Davibeh/Switch_De_Distorcion_Ergonomico/02_ Materiales_y_Compras/Tickets_Recibos/20180318_181217.jpg

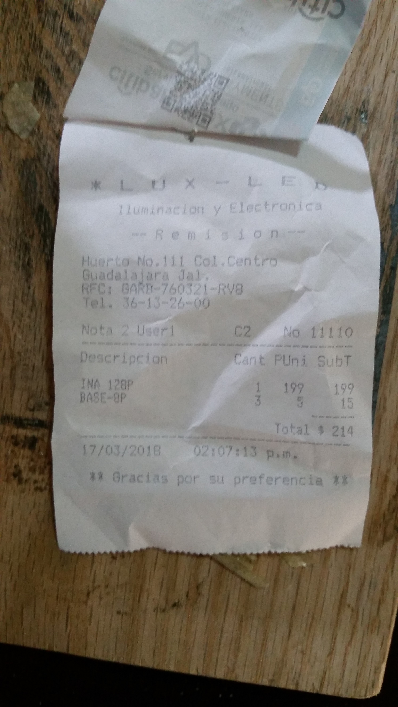
02_ Materiales_y_Compras/Tickets_Recibos/20180318_181217.jpg
