Davibeh/Switch_De_Distorcion_Ergonomico/01_PM/WBS_Plan_ALFA_Switch_de_distorción_ergonómico.pptx

Switch de distorsión ergonómico
(Variante ALFA)
Desarrollo de 2 circuitos de offset y ganancia
Diseñar circuito con amplificadores operacionales para amplificar y agregar un offset a una señal
Electro-miógrafo
Armar el circuito diseñado en protoboard
Diseñar el layout del circuito funcional
Desarrollar tarjeta de desarrollo
Diseñar un circuito capaz de leer biopotenciales musculares y amplificarlos
Armar el circuito en protoboard
Probar el circuito armado
Diseñar layout
Desarrollar tarjeta de desarrollo
Probar circuito armado
Firmware
Hardware
Probar tarjeta de desarrollo
Probar tarjeta de desarrollo
Driver para convertidor analógico a digital(ADC)
Desarrollo de drivers
Efectos de sonido
Electro-miógrafo
Driver para Digital to Analog Converter (DAC)
Driver para General Purpose input/output (GPIO)
Driver para Periodic interrupt timer (PIT)
Desarrollar algoritmo para obtención de datos
Desarrollar algoritmo para procesamiento de datos
Encapsular ambos algoritmos en una función
Desarrollar algoritmo de obtención de datos
Desarrollar algoritmo para generar efecto de sonido: echo
Desarrollar algoritmo para generar efecto de sonido: distorsión
Desarrollar algoritmo para generar efecto de sonido: vibrato
Encapsular una función por efecto que contenga el algoritmo de obtención de datos y el algoritmo para generar el efecto respectivo
Análisis previo y compras
Realizar BOM para dos circuitos de offset y ganancia
Realizar BOM para electro-miógrafo
Ir comprar los objetos listados en las BOM realizadas
Administración de juntas para el proyecto juntas
Administración de tares para el proyecto
Creación de matriz raci
Documentación
Creación del proyecto charter
Ejecución de pruebas de variante alfa
Revisión del documento de diseño
