Davibeh/Switch_De_Distorcion_Ergonomico/01_PM/WBS_Plan_BETA_Switch_de_distorción_ergonómico.pptx

Switch de distorsión ergonómico
(Variante BETA)
HW de Audio
HW de suma y resta analógica para el audio.
Electro-miógrafo
Entendimiento del HW del electro miógrafo
Puntos de medición identificados.
Preparación de plan BETA
Hardware
Rediseño
Plan definido de variante BETA
Material comprado para variante BETA
Arquitectura de HW modificada
Arquitectura de SW modificada
Miógrafo de un proveedor externo
Materiales varios como JACKs de audio
Software
Software de detección de movimiento del miógrafo
Software de generación de señal de distorsión
Software de sistema mínimo par el control del procesador.
HW de instrumentación señal salida de miógrafo
HW y SW integrado
Integración
Pruebas del sistema
