Davibeh/Switch_De_Distorcion_Ergonomico/01_PM/Minutas de Juntas/G Proyectos de Sw.pdf

- Definir alcance del proyecto, enuncia enlistando el objetivo.
- Generar Project Charter.
- Definir personas involucradas y competencias de cada una.
- Matriz RACI.
- Definir WBS.
- Actividades de desarrollo, metodología de desarrollo de SW.
- Presupuesto
- Tiempo estimado de las actividades.
- Personas asignadas.
- Definir juntas de estado (Semanales)
- Planeación:

Agenda:

# Fechas importantes

Fecha de entrega 14 de Abril
Dias semana natural:

### 35 dias

_______________________________________ Disponibilidad
Chung: Jueves 29 Marzo al domingo 1 de Marzo

Gerardo Vacaciones:
Lunes a viernes : Apartir de las 5pm
Sabado 24 de Marzo - 25 de Marzo Jueves 29 de Marzo 1 de Abril

Obejtivo del proyecto:

Gerardo enunciado: Prototipado de un pedal activado por biopotenciales. Que incluye el prototipado:
Demostración de un protopido de pedal activado por biotenciales.

Background:
El humano ha dependido de la utilización de elementos externos que cumplen el rol de interfaz para traducir el objetivo de control del humano a las maquinas que servirán de actuadores. Estos elementos externos plantean un problema por la baja integración que tienen con el controlador humano.
La importancia de crear elementos interface que se acoplen de manera ergonómica al controlador humano es la tendencia moderna para crear nuevos dispositivos electrónicos en diferentes áreas, como el caso de la electrónica de consumo tales como teclados, pizarrones virtuales, etc.

Objetivo:
Para la industria de la música la adquisición de equipo es un tema primordial, buscando tener equipo que provea la mejor calidad de audio. la instalación de estos equipos en las presentaciones en vivo resultan un contratiempo, un caso muy particular para los guitarristas los pedales de distorcion cumplen una funcion primordial, pero mantienen a los muscios en un area para poder indicar los cambios de distorcion a lso sonidos de la guitarra.
El proyecto tienen como objetivo el crear un prototipo de pedal que se integre ergonomiament al musico donde los cambios de distoricion estaran cotnrolador por el movimiento de las piernas del musico, dandole la liberdad de movimiento en el escenario.
- Chung: Programan, HW
- Gerardo Programa, HW
- Eduardo Gamboa Pro, Hw , Git
- David Pro, HW
- Tooling: Git

CMP:

TODO: Entrenamiento o manual.

SW Driver pre existentes:

- Driver de ADC.
- Driver de de timer PIT
- Driver de DAC 12 bits
- GPIOS drivers
- Efectos de sonido
- Evaluador miagrafo (modificacion par aun canal extra)
- Pedal applicacion

Capa de apliacion:

Proceso de Activación:

Sera de dos fases, una fase sera la permisiva y la segunda fase sera la de actiación:

•

LA primera fase se locarizaro en los cuadricepts de la peirna derecha.

LA segunda sera en los gemelos.

Experiencia de usuario:
Es la de estirar la pierna e inclinar el pie hacia abajo para activar o desactivar el efecto.

El usuario seleccionara manualmente el efecto con un boton.

La intesidad de los efectos de sonido sera controlada por un unico ptenciametro.

La cantidad de efectos disponibles era de 3:

1- Vibrato
Eco2-
3- Distorcion

Horas de trabajo al dia son 4 horas

WBS:

- Project Charter(Documentacion inicial)
- Escritura de requeremientos de sistema.

Requirement enginieering:

- HW/SW architecture creation.

HW/SW Architecutre:

- Construir proto con hw de miografo
- Validar contruccion del proto
- Design Migrafro HW.
- Contrurir proto
- Validar proto
- Deseing migrafo intrumentation hw (no negative)
- HW integration test. (SW integration test)
- PCB deseing
- PCB construction
- PCB validation

HW disipline:

HSI

- Adaptacion de Codewarrior a Mcu expresso 1 de trabajo
- Validation of the sw 1 dia de trabajo lunes pruebas
- BSW preparación:
- Aplication coding 16 dias.
- Escribir pruebas de SW
- Ejecutar pruebas de SW

SW discipline:

Calibration of the SW

- MCU expresso.
- Doxygen--> instalation for Chung

SW Tooling:

- Platform listo

Para miecoloes:

- No tener ningun HW preehecho.
Caso de etner HW prehecho la adaptacipn y entendiento del HW puede consumir tiempo.

•

Riesgos:

# 10/03/18: Junta de equipo definición del proyecto

viernes, 09 de marzo de 2018 06:53 p.m.

G Proyectos de Sw Page 1

Materiales:

- Electrodos -> 50 ~ $400 tiempo de adiquision 1dia.
Cables electrodos 1 por fase ---$300 1 semana en llegar desde que se pide --> al momento de prueas de integración. --> Miercoles. Ya habra estatus.

•

- Jueves compra de materiales.
- HW del miografo (dieño de la terjeta y contruccion de la misma) 4 dias
- Compra 741 no. Otro si.
- INA ( Instrumentation Ampliafiar)
- Guitarra
- Amplificador
- Cable de guitarra
- Adapador de jacks.
- Op amp de salida.
- Validation of the sw 1 dia de trabajo lunes pruebas
- Aplication coding 16 dias.
- Escribir pruebas de SW
- Ejecutar pruebas de SW
- Pruebas de integracón

Pruebas systemas

- No tener ningun HW preehecho.
Caso de etner HW prehecho la adaptacipn y entendiento del HW puede consumir tiempo.

•

- Quemado del HW prehecho. Del miografo.
- Queado del HW ya hecho
- Tarjeta de desarrollo quemada.
- Impedancia de la piel que no permita leer la informacion (muy bajo riegos)
- Que se desponga el disco duro.

Riesgos:

Riesgo:

- Osciloscopio
- Fuente

Equipo durante la parte de vacaciones

Pedir oscilosopio
A concoidos

G Proyectos de Sw Page 2
