Davibeh/Switch_De_Distorcion_Ergonomico/01_PM/WBS_Plan_ALFA_BETA_INTEGRATION_Switch_de_distorción_ergonómico.pptx

Switch de distorsión ergonómico
Integración ALFA BETA
Integración
Integración del HW de la variante ALFA y BETA
Pruebas de integración
Preparación de plan ALFA BETA
Hardware
Proyecto en un servicio de almacenamiento en la nube.
Software
Pruebas de integración del software
Software de muestreo de Audio
Integración del software de control de Electro miógrafo y muestreo de audio
Pruebas de integración del sistema con guitarra eléctrica.
Integración
Tickes de actividades pedientes
