Davibeh/Switch_De_Distorcion_Ergonomico/03_Investigacion_y_Desarrollo/02_Arquitectura/Arquitectura software_Imagen_Gerardo.jpg

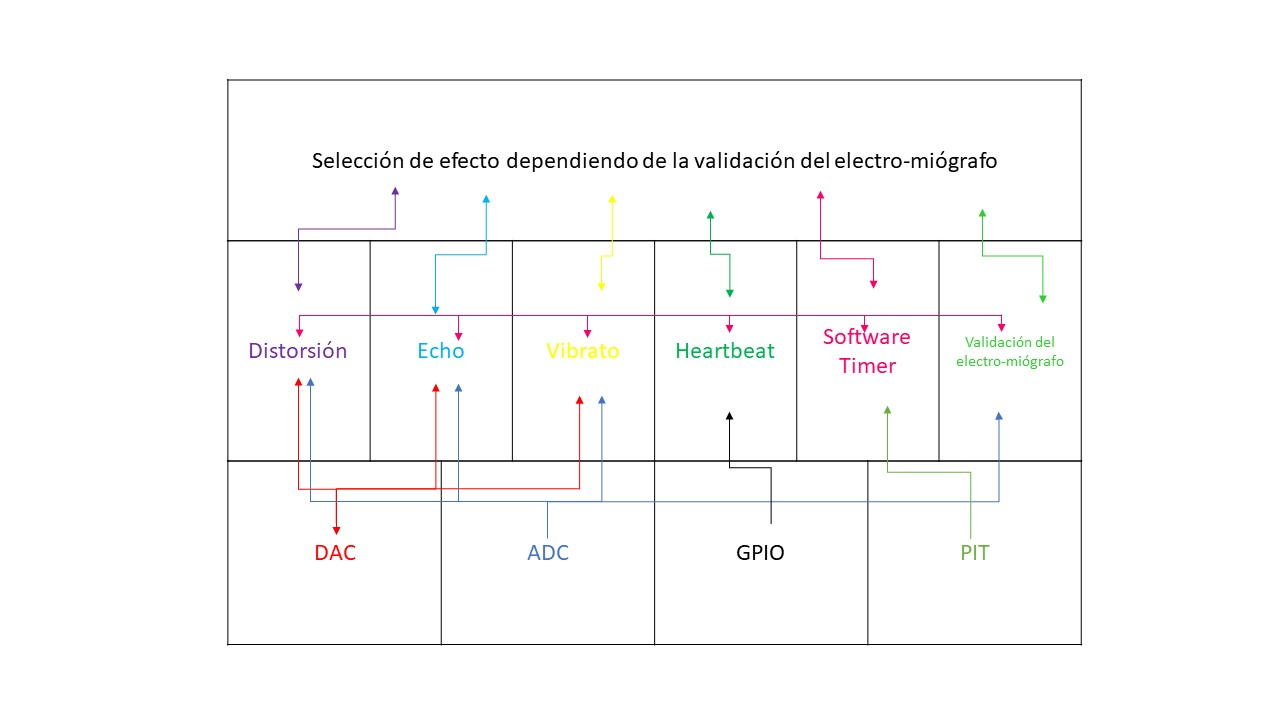
03_Investigacion_y_Desarrollo/02_Arquitectura/Arquitectura software_Imagen_Gerardo.jpg
