Davibeh/Switch_De_Distorcion_Ergonomico/02_ Materiales_y_Compras/BOM para Proyecto.xlsx

Sheet: Sheet1
Refdes | Cantidad | Descricpion
Resistencia 10k ohm | 19
Resistencia 240 ohm | 1
Resisencia 1Kohm | 5
Resistencia 4.7Kohm | 5
Resistencia 150kohm | 5
Resistencia 15Kohm | 5
Resistencia 27Kohm | 5
Potenciometro ?? | 1 | En el esquematico del electromiografo hay un potenciometro llamado R13 pero este no especifica el rango de su resistencia.
Potenciometro-50k | 4 | 50 k
Potenciometro 100k | 4 | 10k
Conector de Audio analogico | 7 | jack hembra de 3.5mm para stereo
lm358 | 5 | Amplificadores operacionales duales 8 pins
capacitor 4uf | 6
Capacitor ,1uf | 3
Capacitor 220nf | 3
Capacitor 100nf | 3
OpAmp | 3 | TL082P
Diodo 1N4004 | 2
Diodo 1N4148DO35-10 | 2
Amplificador de instrumentacion | 1 | No se la matricula
Base para IC | 7 | Base dip para circuito integrado 8 pines

Sheet: Electro_Miografo
Part | Value | Device | Package
C1 | 220n | CPOL-USE2-5 | E2-5
C5 | .1u | CPOL-USE2-5 | E2-5
C6 | 100n | CPOL-USE2-5 | E2-5
C7 | 100n | CPOL-USE2-5 | E2-5
D1 | 1N4148DO35-10 | 1N4148DO35-10 | DO35-10
D2 | 1N4148DO35-10 | 1N4148DO35-10 | DO35-10
D3 | 1N4004 | 1N4004 | DO41-10
D4 | 1N4004 | 1N4004 | DO41-10
IC1 | INA128P | INA128P | DIL08
IC2 | TL082P | TL082P | DIL08
IC3 | TL082P | TL082P | DIL08
R1 | 240 | R-US_0207/12 | 0207/12
R2 | 150k | R-US_0207/12 | 0207/12
R3 | 10k | R-US_0207/12 | 0207/12
R4 | 10k | R-US_0207/12 | 0207/12
R5 | 4.7k | R-US_0207/12 | 0207/12
R6 | 1k | R-US_0207/12 | 0207/12
R7 | 1k | R-US_0207/12 | 0207/12
R8 | 27k | R-US_0207/12 | 0207/12
R9 | 27k | R-US_0207/12 | 0207/12
R10 | 15k | R-US_0207/12 | 0207/12
R11 | 15k | R-US_0207/12 | 0207/12
R12 | 15k | R-US_0207/12 | 0207/12
R13 |  | 3RP/1610N | 3RP/1610N
R14 | 1k | R-US_0207/12 | 0207/12
X1 | 22-23-2031 | 22-23-2031 | 22-23-2031 | Conectores
X2 | 22-23-2031 | 22-23-2031 | 22-23-2031
X3 | 22-23-2031 | 22-23-2031 | 22-23-2031
