Davibeh/Switch_De_Distorcion_Ergonomico/03_Investigacion_y_Desarrollo/01_Requerimientos/Req_Switch_Ergonomico.xls

Proyecto |  |  | Switch Ergonomico
Documentos de Referencia |  |  | Reference documents
Revisado por |  |  | Nombre del Revisor |  |  |  |  |  | Extra requirement traceability information Comments and deviations |  | Design Traceability |  | Code Traceability |  |  | Testing Traceability Matrix
 |  |  |  | Estado | Implementación | Completo | Trazable a | Verificable
Id | Tipo | Sección | Requerimientos |  |  |  |  |  | Comentarios 1 | Comentarios 2 | Documento/Sección | Comentarios | Module/Files | Functions | Comments | Document/Test ID | Comments
RQ001 | No Funcional | Cabezera | Detección del Movimiento | Propuesto
RQ002 | Funcional | Requerimiento | El sistema debe de detectar el movimiento del musculo gastrocnemio | Propuesto
RQ003 | Funcional | Requerimiento | El movimiento del músculo debe ser medido usando electrodos siguiendo el principio de la electromiografia. | Propuesto
RQ004 | Funcional | Requerimiento | Se deberá utilizar 3 electrodos siguiendo el principio de voltage diferencial y voltaje de referencia. | ASD
RQ005 | Funcional | Requerimiento | La señal de voltaje extraida de los electródos deberá ser instrumentada para el posterior procesamiendo de un microprocesador. | Propuesto
RQ006 | Funcional | Requerimiento | La fase de instrumentación de la señal de voltaje debera constar de tres fases: 1- Diferenciación de voltaje y amplificación de la diferencia (por ejemplo usando un amplificador de instrumentación). 2- Fase de rectificación de señal. 3- Fase de desacoplamiento. 4- Fase de atenuación de picos de voltage. | Propuesto
RQ007 | Funcional | Requerimiento | La señal de voltaje de salida del proceso de intrumentación deberá ser de naturaleza de corriente directa. | Propuesto
RQ008 |  |  | El valor de voltaje de corriente directa de salida del proceso de intrumentación será directamente proporcional al movimiento del músculo. | Propuesto
RQ009 | No Funcional | Requerimiento | El implementador deberá tipificar la relación entre los niveles de voltage obtenidos de la fase de intrumentación y el movimiento del musculo gastrocnemio. | Propuesto
RQ010 | Funcional | Requerimiento | El procesador deberá de muestrear la señal de voltaje para detectar cualquier variacion de la amplidud de la misma con un periodo máximo de 100ms. | Propuesto
RQ011 | Funcional | Requerimiento | El procesador deberá de detectar la existencia de movimiento en el músculo y notificar de este evento al SW de control. | Propuesto
RQ012 | No Funcional | Requerimiento | La señal de voltaje obtenida de la fase de instrumentación deberá de lograr un rechazo de modo común a las señales de ruido, logrando asi un valor maximo de la relación Señal/Ruido y una distroción minima. | Propuesto
RQ013 | No Funcional | Cabezera | INTERFAZ DE USUARIO
RQ014 | No Funcional | Requerimiento | El usuario deberá de ser capaz de activar o desactivar el efecto de sonido aplicado al audio mediante un movimiendo sencillo del pie | Propuesto
RQ015 | Funcional | Requerimiento | El movimiento de desactivacion cosnistirá en el mostrado en la figura mientras el usuario se encuentra en posicion de sentado y el efecto de audio esta desactivado. | Propuesto
RQ016 | Funcional | Requerimiento | El movimiento de desactivacion cosnistirá en el mostrado en la figura mientras el usuario se encuentra en posicion de sentado y el efecto de audio esta activado. | Propuesto
RQ017 | No Funcional | Cabezera | MUESTREO DE AUDIO
RQ018 | Funcional | Requerimiento | El muestreo de Audio por parte del procesador deberá tener un periodo maximo de 84us | Propuesto
RQ020 | NoFuncional | Cabezera | SALIDA DE AUDIO | Propuesto
RQ021 | Funcional | Requerimiento | La frecuencia de muestreo de la señal de audio debera ser de 20khz | Propuesto
RQ022 | Funcional | Requerimiento | La frecuencia de muestreo de la señal del miografo debera ser de 20khz | Propuesto
RQ023 | Funcional | Requerimiento | El sistema debeera de contar con la capacidad de aplicar 3 efectos de sonido de audio | Propuesto
RQ024 | Funcional | Requerimiento | El efecto de echo es la suma de la entrada de audio mas la misma entrada desfasada atrás en el tiempo | Propuesto
RQ025 | Funcional | Requerimiento | El efecto de vibrato se monta la entrada de audio a una onda de dientes de sierra | Propuesto
RQ026 | Funcional | Requerimiento | El sistsistema debera teber la capacidad de muestrear y validar la señal de voltage y validar ka selak de voltage provista por el usuario | Propuesto
RQ027 | Funcional | Requerimiento | El sistema debera de ser capas de contar con periferico de salida de voltage alaolgico | Propuesto
RQ028 | Funcional | Requerimiento | El sistema debera ser capas de contar con un periferico de entrada de voltage abnalogico | Propuesto
RQ029 | Funcional | Requerimiento | El sistema debera ser capas de contar con un periferico de GPIOS | Propuesto
RQ030 | Funcional | Requerimiento | El sistema debera ser capas de contar con un periferico de timer | Propuesto
RQ031 | Funcional | Requerimiento | El procesador deberea dar la salida de audio por el modulo DAC0 | Propuesto
RQ032 | Funcional | Requerimiento | La app total debera seleccionar el efecto dependiendo de la validacion del electro-miografo | Propuesto
RQ033 | Funcional | Requerimiento | La sallida debera presentar los efectos de distorsion ,echo y vibrato dependeiendo de la selección del usuario | Propuesto
RQ034 | Funcional | Requerimiento | El sistema contara con un selector de modos de distorcion | Propuesto
RQ035 | Funcional | Requerimiento | El pit sera encargado de de administrar los tiempos | Propuesto
