Davibeh/Switch_De_Distorcion_Ergonomico/03_Investigacion_y_Desarrollo/04_Implementacion_SW/SDDE/doc/SW Embedded Tutorials.docx

[SW Embedded Tutorials] Digital To Analog Converter

Descripcion:

En este tutorial describiremos de manera breve el convertidor Digital a Analogico. Ademas se mostrara un caso de uso para la plataforma KL25Z.

Links:

Informacion en Wikipedia sobre DAC:

https://es.wikipedia.org/wiki/Conversi%C3%B3n_digital-anal%C3%B3gica

Pagina NXP KL25Z:

https://www.nxp.com/products/processors-and-microcontrollers/arm-based-processors-and-mcus/kinetis-cortex-m-mcus/l-seriesultra-low-powerm0-plus/freedom-development-p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

Pagina SDK KL25Z:

https://www.nxp.com/support/developer-resources/reference-designs/software-development-kit-for-kinetis-mcus:KINETIS-SDK
