Davibeh/Switch_De_Distorcion_Ergonomico/03_Investigacion_y_Desarrollo/02_Arquitectura/Manual para abrir el archivo de arquitectura.docx

Manual para abrir el archivo de arquitectura

Autor: David Bellomo

Fecha: 29/03/18

Paso 1:

Ir a https://www.draw.io/

Paso 2:

Seleccionar la opción de Device

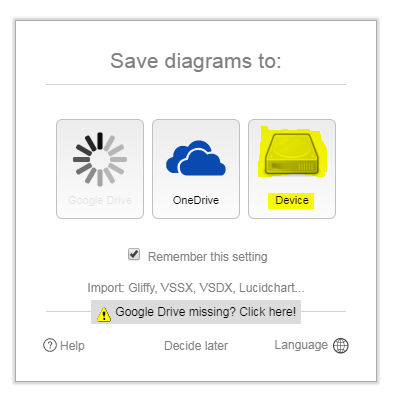
[picture p13: figure]

Paso 3:

Seleccionar la opción “Open Existing Diagram”

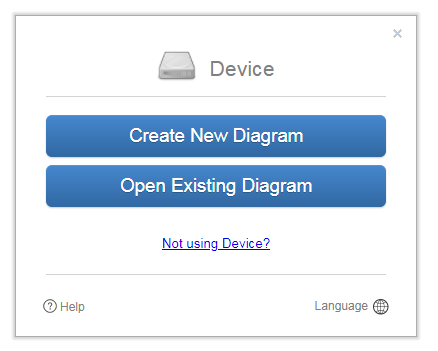
[picture p14: figure]

Paso 4:

Ubicar el archivo llamado “SW_HW_Architecture_Switch_Ergonomico.xml” y abrirlo.

Paso 5:

Empezar con la navegación/modificación de los diagramas

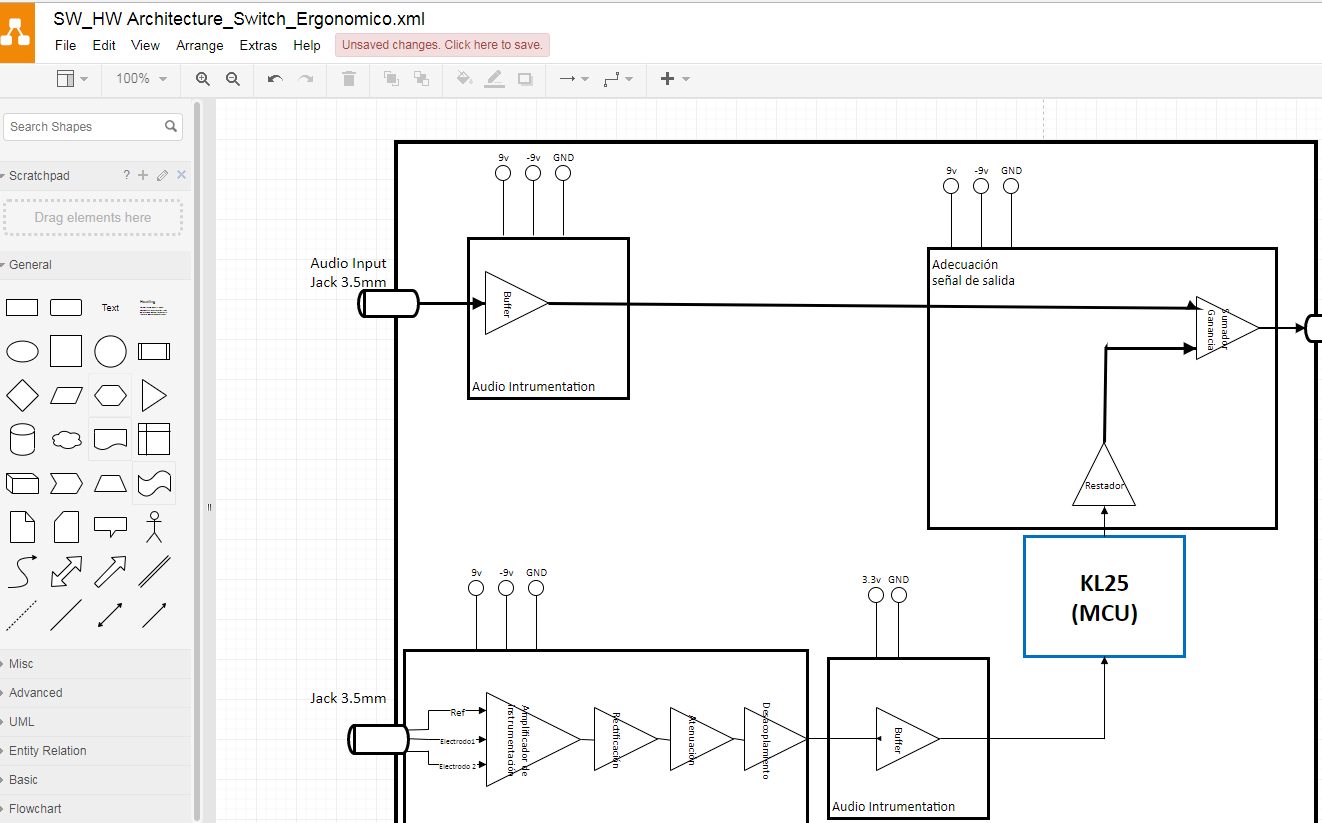
[picture p15: figure]
