Davibeh/Switch_De_Distorcion_Ergonomico/(threads)

Thread 1 (2018-03-30):

Crear Matriz RACI

Davibeh, 2018-03-30:
Esta tarea es para crear una Matriz RACI del proyecto.

Davibeh, 2018-03-30:
[Matriz_RACI_CCTV_Fam_Martínez.xlsx - Matriz RACI-2.pdf](https://github.com/Davibeh/Switch_De_Distorcion_Ergonomico/files/1864971/Matriz_RACI_CCTV_Fam_Martinez.xlsx.-.Matriz.RACI-2.pdf)

**Archivo que muestra un ejemplo de una matriz RACI.**

NoriegaGerardo, 2018-03-31:
[Raci.xlsx](https://github.com/Davibeh/Switch_De_Distorcion_Ergonomico/files/1865016/Raci.xlsx)

Davibeh, 2018-03-31:
**Porfavor mover el issue a "in progress"**

[Raci_Comentarios_David_Bellomo.xlsx](https://github.com/Davibeh/Switch_De_Distorcion_Ergonomico/files/1865069/Raci_Comentarios_David_Bellomo.xlsx)

He agregado  un formato nuevo a tu matriz. Te quedó muy bien, solo hace falta coordinarse con Chung para agregar las Fases del proyecto. Basete un poco en el PDF que esta adjunto en esta conversación.
Muy probablemente cuando agreguen las fases será requerido agregar mas actividades en tu columna "B"

NoriegaGerardo, 2018-03-31:
[raciv2.xlsx](https://github.com/Davibeh/Switch_De_Distorcion_Ergonomico/files/1865805/raciv2.xlsx)
ya agrege las partes del pdf @EdgarChung ve si puedes agregar las fases en tu issue

Closed 2018-04-09.

Thread 2 (2018-03-30):

Creación de documentos de Diseño de SW

Davibeh, 2018-03-30:
Creación del documento de diseño de SW. Este documento contendrá los detalles de diseño tales como frecuencias de muestreo, nombre de las funciones e interfaces definidas.
Al igual que la interacción con otros módulos.

Closed 2018-04-01.

Thread 3 (2018-03-30):

Creación Project  Charter

Davibeh, 2018-03-30:
Esta actividad consisten en la creación del project Charter:
-  Cargar todos los datos obtenidos durante la junta del kickoff de Marzo 10 en un documento formal.
Deberá de contener los siguientes capítulos:
1- Introdución
2- Resumen Ejecutivo
3- Alcance del proyecto ( Con sub capítulos para definición de costos, riesgos, objetivos, metas, etc)
4-  Matriz de flexibilidad
5- Organización del proyecto.
6- Firmas

Davibeh, 2018-04-01:
@EdgarChung  Porfavor ayudame a crear el project charter. Haz una version incial del project charter.
Basate en este archivo template y velo llenando
[Project_Charter_Switch_de_distorcion_ergonomico.docx](https://github.com/Davibeh/Switch_De_Distorcion_Ergonomico/files/1866199/Project_Charter_Switch_de_distorcion_ergonomico.docx)

Un ejemplo del project charte es este archivo:

[PROJECT_CHARTER_TECH_SECURITY.docx.pdf](https://github.com/Davibeh/Switch_De_Distorcion_Ergonomico/files/1866200/PROJECT_CHARTER_TECH_SECURITY.docx.pdf)

En este archivo de word esta parte de las anotaciones que hice en las juntas de equipo:
[Anotaciones_del_proyecto.docx](https://github.com/Davibeh/Switch_De_Distorcion_Ergonomico/files/1866203/Anotaciones_del_proyecto.docx)

EdgarChung, 2018-04-11:
esto es lo que tengo
[Project_Charter_Switch_de_distorcion_ergonomico.docx](https://github.com/Davibeh/Switch_De_Distorcion_Ergonomico/files/1897261/Project_Charter_Switch_de_distorcion_ergonomico.docx)

EdgarChung, 2018-04-11:
segunda entrega se agrego matriz de flexibilidad
[Project_Charter_Switch_de_distorcion_ergonomico.docx](https://github.com/Davibeh/Switch_De_Distorcion_Ergonomico/files/1897273/Project_Charter_Switch_de_distorcion_ergonomico.docx)

Davibeh, 2018-04-19:
[Project_Charter_Switch_de_distorcion_ergonomico (2).docx](https://github.com/Davibeh/Switch_De_Distorcion_Ergonomico/files/1926279/Project_Charter_Switch_de_distorcion_ergonomico.2.docx)

Thread 4 (2018-03-30):

Creación del WBS

Davibeh, 2018-03-30:
Crear el WBS para el proyecto de las actividades que se realizaron en el desarrollo del proyecto.
Coordinarse con Gerardo cuando se cree la Matriz RACI, ya que las actividades a realizar están ligadas  alas actividades en el WBS.
Usar archivo adjunto de ejemplo.
Crear el diagrama en https://www.draw.io/ y exportarlo como .html.

Davibeh, 2018-03-30:
[Visio-WBS_INSTALACION Y PUES EN SERVICIO DE UN SISTEMA DE CCTV PARA SEGURIDAD DOMESTICA.vsdx.pdf](https://github.com/Davibeh/Switch_De_Distorcion_Ergonomico/files/1864965/Visio-WBS_INSTALACION.Y.PUES.EN.SERVICIO.DE.UN.SISTEMA.DE.CCTV.PARA.SEGURIDAD.DOMESTICA.vsdx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)

EdgarChung, 2018-03-31:
[wbs pedal.pptx](https://github.com/Davibeh/Switch_De_Distorcion_Ergonomico/files/1865048/wbs.pedal.pptx)

Davibeh, 2018-03-31:
Porfavor mover el issue a "In Progress".

Las actividades van orientadas a la parte técnica pero es necesario que agregues las actividades que se hicieron de compras analisis y pruebas.

EdgarChung, 2018-04-01:
[wbs pedal.pptx](https://github.com/Davibeh/Switch_De_Distorcion_Ergonomico/files/1866052/wbs.pedal.pptx)
ya quedo

Davibeh, 2018-04-01:
Te quedó excelente lo subiré al proyecto en brevé. Mcuhas gracias ya estamos mas cerca del éxito.

Closed 2018-04-01.

Thread 5 (2018-03-30):

Revision del Documento de Diseño

Davibeh, 2018-03-30:
Esta actividad engloba la revisión del documento de diseño enviado por Chung, adjunto a este issue.
**## Los comentarios se harán en este mismo issue.**
Y al final se enviarán a Chung para su posterior corrección.

[Pedal de guitarra.docx](https://github.com/Davibeh/Switch_De_Distorcion_Ergonomico/files/1864950/Pedal.de.guitarra.docx)

Thread 6 (2018-03-30):

Integración del Controlador del Miografo

Davibeh, 2018-03-30:
El SW ha sido desarrollado por Chung, pero este fue creado en Code Warrior, es necesario agregar el código en una configuración de MCUxpresso por si se requiere hacer modificaciones.

El código se integrara con el Código actualmente de proyecto Beta.

Davibeh, 2018-04-01:
El commit: a33a659cfe6ddf5404294f1891f0ac9209b530cf

Incluye la primera configuración del ADC con un tiempo de converción de 2.5us  y un periodo de muestreo de 100Khz.

Davibeh, 2018-04-01:
El commit: d5fd9a49f4a9aa57a54c685cb222151685baff8c

Incluye la integración de la variante alpha y la variante beta. El muestreo de audio funciona muy bien, la única afectación es que el scheduler no puede ejecutar la tarea de EMG ya que la interrupción de muestreo de audio es muy rápida. La solución fue la de mover la tarea de EMG a la IRQ  del PIT de esta forma ambas tareas ejecutan en el mismo ambiente.  El audio se muestres de manera buena y el movimiento se detecta el problema es que las tierras están mal acopladas en mi computadora y es necesario desacoplaras para tener un voltaje bueno para detectar el movimiento del musculo.

Davibeh, 2018-04-01:
Ya se encontró el problema del issue reportado en #11 .  Ahora se encontró otro problema de HW,  las tierras no estan bien acopladas y esto causa un ruido en linea cuando la tarjeta se alimenta por computadora y con baterias de 9v, se intentó alimentar el circuito usando dos baterias de 9v para generar +-9v, pero el circuito del offset requiere 5v el cual no es posible de generar ya que la salida de la tarjeta de desarrollo está conectada directamente al voltage de 5v del usb.

La solución es buscar un regulador de 5v o buscar la menra de alimentar el ciucito de offset con 3.3v.

Thread 7 (2018-03-30):

Ejeción de pruebas en variante Alfa

Davibeh, 2018-03-30:
Ejecutar pruebas de la variante Alfa de acuerdo a la especificación de pruebas entregada por Chung, adjunta a este issue.

[guia de pruebas.docx](https://github.com/Davibeh/Switch_De_Distorcion_Ergonomico/files/1864964/guia.de.pruebas.docx)

Davibeh, 2018-03-31:
No se ha podido continuar con las pruebas ya que el HW del segundo offset está incompleto es necesario idear un plan de contención.

@EdgarChung  Podrias Buscar en tus cosas el HW del offset?

Aqui esta el reporte:

[Reporte_de_Rpuebas_Variante_Alfa_David_Bellomo.docx](https://github.com/Davibeh/Switch_De_Distorcion_Ergonomico/files/1865074/Reporte_de_Rpuebas_Variante_Alfa_David_Bellomo.docx)

Davibeh, 2018-04-01:
@EdgarChung  Has podido encontrar el HW del offset?

Thread 10 (2018-04-01):

Revisión de Requerimientos

Davibeh, 2018-04-01:
He agregado comentarios a la hoja de excel que enviaste. ¿Podrías revisarlos y corregir los requerimientos?

[Requerimientos_Propuesto_Gerardo.xlsx](https://github.com/Davibeh/Switch_De_Distorcion_Ergonomico/files/1866079/Requerimientos_Propuesto_Gerardo.xlsx)

**Recuerda que las celdas que tienen comentarios tienen una marca roja en la esquina superior derecha.

NoriegaGerardo, 2018-04-09:
deje los comentarios del autor para corroborar los cambios
[Requerimientos_Propuesto_Gerardo.xlsx](https://github.com/Davibeh/Switch_De_Distorcion_Ergonomico/files/1891413/Requerimientos_Propuesto_Gerardo.xlsx)

Thread 11 (2018-04-01):

Problemas con el debugger

Davibeh, 2018-04-01:
El SDA debugger toma demasiado tiempo  para iniciar y la tarjeta una vez programada no correrá en standalone, este modo es necesario para una adecuado funcionamiento del SW de EMG.

Davibeh, 2018-04-01:
Se probó la configuración descargada desde github en otra computadora y esta funcionó de manera correcta. La acción es reinstalar MCUxpresso en la computadora donde falla el debuggeo.

Este issue se puede cerrar.

Closed 2018-04-01.

Thread 8 (2018-04-01):

Distorción no funciona con configuración del nuevo sistema

Davibeh, 2018-04-01:
La distorción no funciona cuando se hacen las pruebas de integración entre el modulo Alfa y beta.
La razón es que al parecer el voltaje muestrado no supera el limite definido " 4090 - wMaxParameter < ValueRead"   El wMaxParameter es de 500.

@EdgarChung  Porfavor me podrías indicar cual puede ser la razón,  ¿Es necesario calibrar algo en el código?

Closed 2018-04-01.

Thread 9 (2018-04-01):

Efecto Distorción no funciona

Davibeh, 2018-04-01:
Al parecer el efecto distorción no funciona con el nuevo sistema.
La razón es que el  el voltaje leido no alcanza el valor  limite esperado ( 4090 -wMaxParameter)
con un wMaxParameter de 500.

¿Podrías analizarlo y verificar si es necesario algún tipo de calibración al valor wMaxParameter?

EdgarChung, 2018-04-01:
El max parameter se modica, dependiendo del nivel de distorcion que se quiere, 0 no hay distorcion y mas 1200 se escucharia casi pura distorcion

Closed 2018-04-05.

Thread 12 (2018-04-11):

Presentacion

NoriegaGerardo, 2018-04-11:

NoriegaGerardo, 2018-04-11:
Validar lo que se hizo
[Switch de distorsión ergonómico.pptx](https://github.com/Davibeh/Switch_De_Distorcion_Ergonomico/files/1897234/Switch.de.distorsion.ergonomico.pptx)

EdgarChung, 2018-04-11:
[Pitch switch de distosión ergonómico.docx](https://github.com/Davibeh/Switch_De_Distorcion_Ergonomico/files/1900608/Pitch.switch.de.distosion.ergonomico.docx)

EdgarChung, 2018-04-11:
agregue una diapositiva a la presentación
[Switch.de.distorsion.ergonomico.pptx](https://github.com/Davibeh/Switch_De_Distorcion_Ergonomico/files/1900637/Switch.de.distorsion.ergonomico.pptx)
