Davibeh/Switch_De_Distorcion_Ergonomico/03_Investigacion_y_Desarrollo/03_ Diseño/Electromografo/Electromografo/electromiografo.pdf

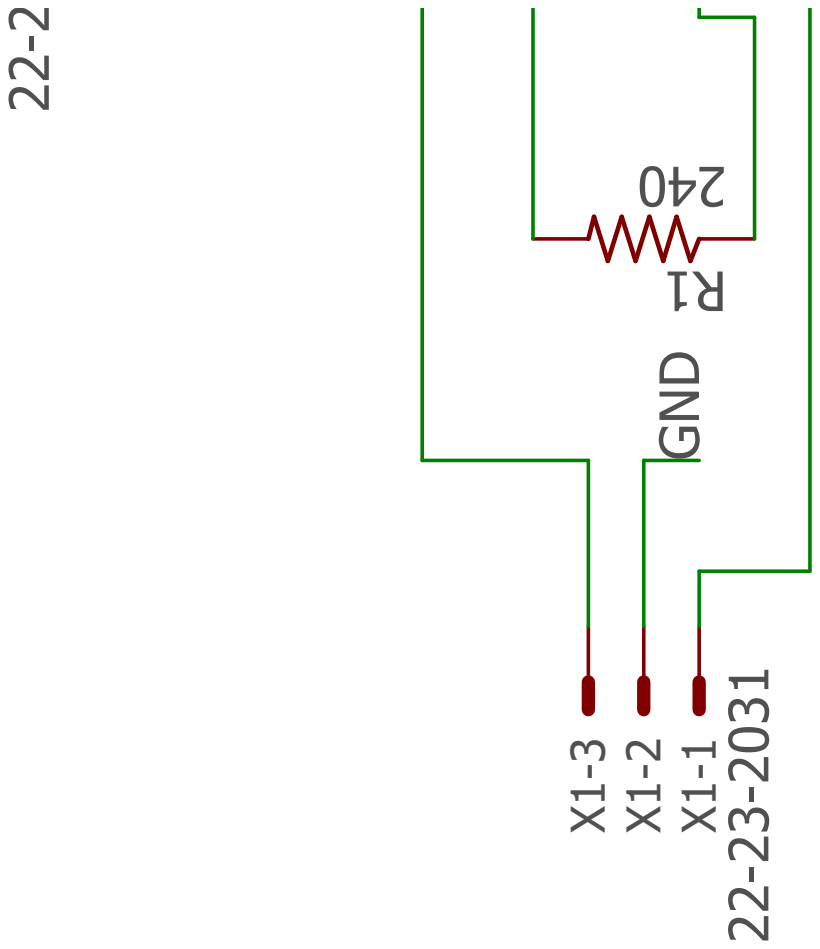
[picture p16: page 1]

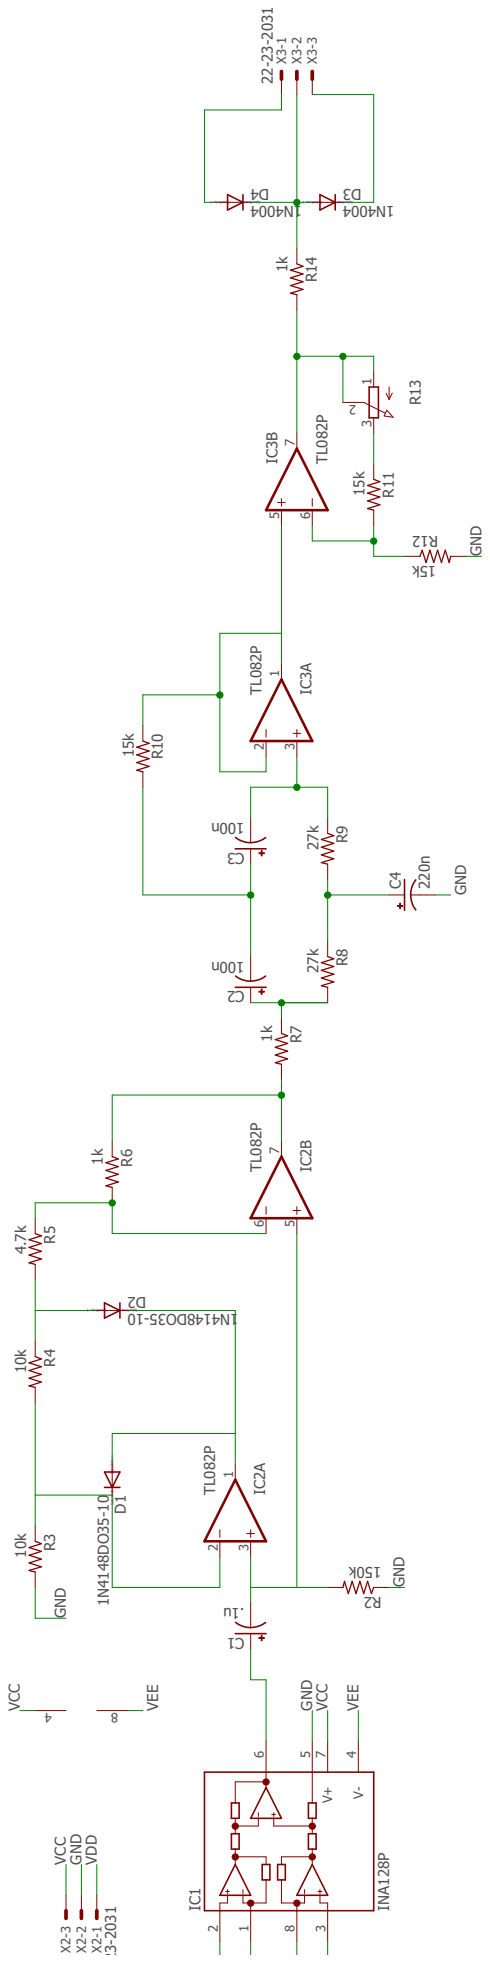
[picture p17: page 2]
