Davibeh/Switch_De_Distorcion_Ergonomico/03_Investigacion_y_Desarrollo/03_ Diseño/off/off/esquem.pdf

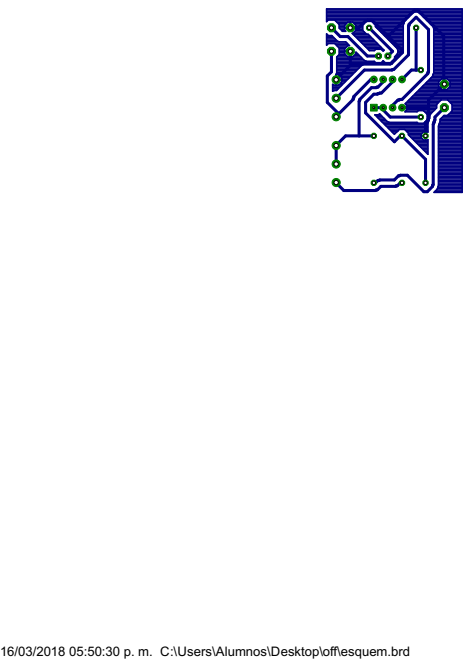
[picture p18: page 1]

16/03/2018 05:50:30 p. m. C:\Users\Alumnos\Desktop\off\esquem.brd
