Davibeh/Switch_De_Distorcion_Ergonomico/03_Investigacion_y_Desarrollo/03_ Diseño/off/off/board.brd

## EAGLE design 03_Investigacion_y_Desarrollo/03_ Diseño/off/off/board.brd (2018-03-30)

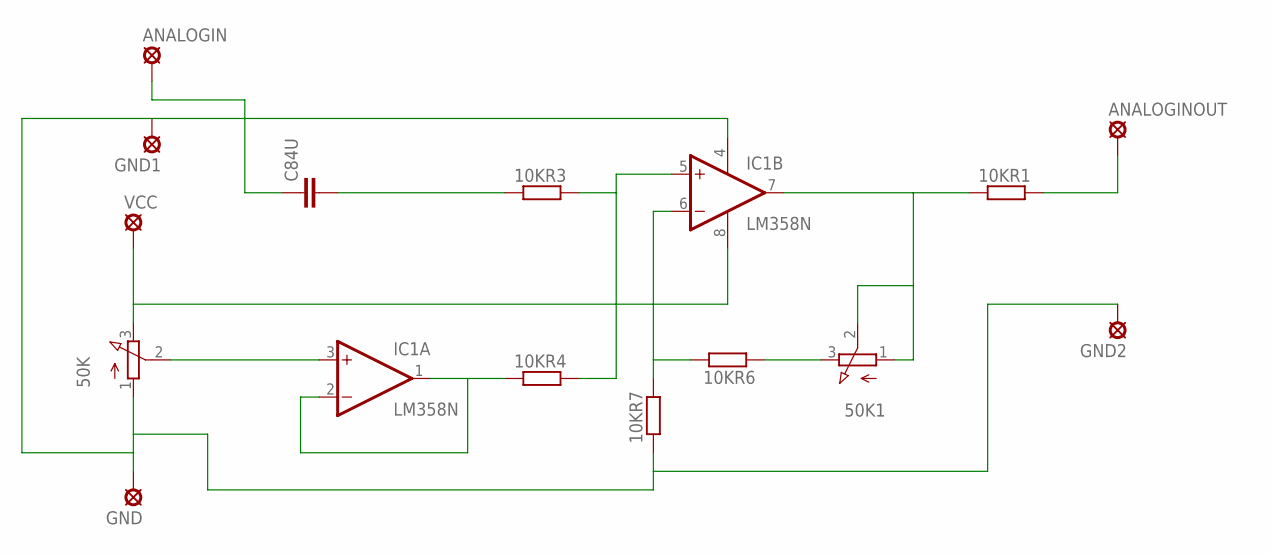
[picture p19: schematic board.sch]

Parts:
10KR1, 10KR3, 10KR4, 10KR6, 10KR7: R-EU_0411/12; 0411/12
50K, 50K1: 3RP/1610N
ANALOGIN: SE11
ANALOGINOUT: SE11
C84U: C2.5/6; C2.5-6
GND, GND1, GND2: SE11
IC1: LM358N; DIL08
VCC: SE11

Connections:
100KR1: 10KR1.1, 50K1.1 (A), 50K1.2 (S), IC1.7 (OUT)
GND: 10KR7.1, 50K.1 (A), GND.MP, GND1.MP, GND2.MP, IC1.4 (V-)
unnamed: 50K.2 (S), IC1.3 (+IN)
unnamed: 10KR4.1, IC1.1 (OUT), IC1.2 (-IN)
unnamed: 10KR3.2, 10KR4.2, IC1.5 (+IN)
unnamed: 10KR3.1, C84U.2
unnamed: ANALOGIN.MP, C84U.1
unnamed: 10KR6.2, 10KR7.2, IC1.6 (-IN)
unnamed: 10KR6.1, 50K1.3 (E)
unnamed: 10KR1.2, ANALOGINOUT.MP
VCC: 50K.3 (E), IC1.8 (V+), VCC.MP

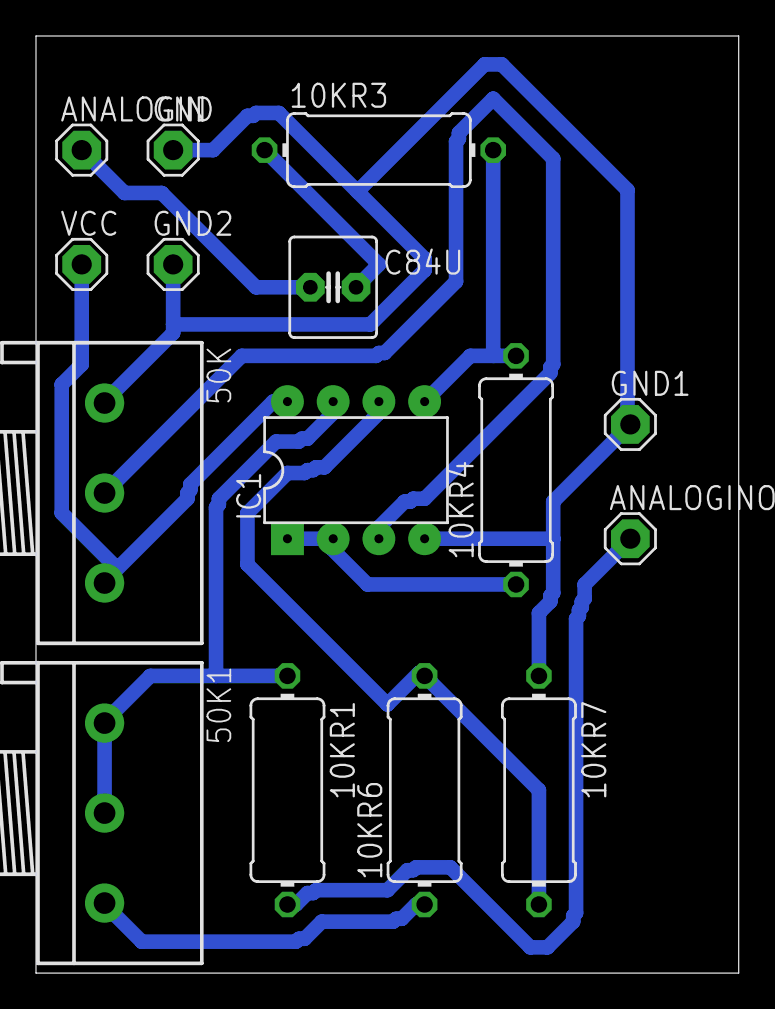
[picture p20: board board.brd from above]

Board: 2 copper layers, 39.0 x 52.1 mm, 15 parts (0 on the bottom side), 11 nets.
