Davibeh/Switch_De_Distorcion_Ergonomico/03_Investigacion_y_Desarrollo/03_ Diseño/Electromografo/Electromografo/electromiografo.brd

## EAGLE design 03_Investigacion_y_Desarrollo/03_ Diseño/Electromografo/Electromografo/electromiografo.brd (2018-03-30)

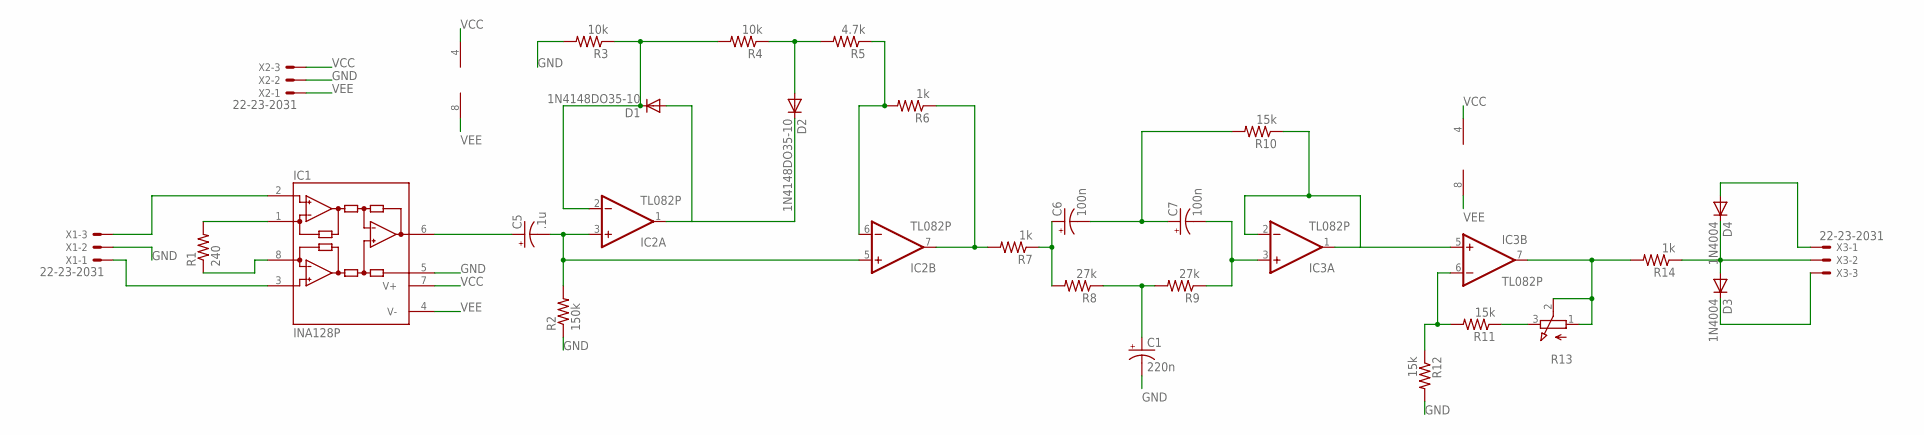
[picture p21: schematic electromiografo.sch]

Parts:
C1: 220n; E2-5
C5: .1u; E2-5
C6, C7: 100n; E2-5
D1, D2: 1N4148DO35-10; DO35-10
D3, D4: 1N4004; DO41-10
IC1: INA128P; DIL08
IC2, IC3: TL082P; DIL08
R1: 240; 0207/12
R2: 150k; 0207/12
R3, R4: 10k; 0207/12
R5: 4.7k; 0207/12
R6, R7, R14: 1k; 0207/12
R8, R9: 27k; 0207/12
R10, R11, R12: 15k; 0207/12
R13: 3RP/1610N
X1, X2, X3: 22-23-2031

Connections:
GND: C1.-, IC1.5 (REF), R2.1, R3.2, R12.2, X1.2, X2.2
unnamed: IC1.2 (-IN), X1.3
unnamed: IC1.1 (RG), R1.2
unnamed: IC1.8 (RG), R1.1
unnamed: IC1.3 (+IN), X1.1
unnamed: D1.C, IC2.2 (-IN), R3.1, R4.2
unnamed: C6.+, R7.1, R8.2
unnamed: C5.-, IC2.3 (+IN), IC2.5 (+IN), R2.2
unnamed: C6.-, C7.+, R10.2
unnamed: C5.+, IC1.6 (OUT)
unnamed: C1.+, R8.1, R9.2
unnamed: C7.-, IC3.3 (+IN), R9.1
unnamed: IC3.1 (OUT), IC3.2 (-IN), IC3.5 (+IN), R10.1
unnamed: D1.A, D2.C, IC2.1 (OUT)
unnamed: D2.A, R4.1, R5.2
unnamed: IC2.6 (-IN), R5.1, R6.2
unnamed: IC2.7 (OUT), R6.1, R7.2
unnamed: IC3.6 (-IN), R11.2, R12.1
unnamed: R11.1, R13.3 (E)
unnamed: IC3.7 (OUT), R13.1 (A), R13.2 (S), R14.2
unnamed: D3.A, D4.C, R14.1, X3.2
unnamed: D4.A, X3.1
unnamed: D3.C, X3.3
VCC: IC1.7 (V+), IC2.4 (V-), IC3.4 (V-), X2.3
VEE: IC1.4 (V-), IC2.8 (V+), IC3.8 (V+), X2.1

Board: 2 copper layers, 28 parts (0 on the bottom side), 25 nets, no tracks yet.
