Davibeh/Switch_De_Distorcion_Ergonomico/03_Investigacion_y_Desarrollo/04_Implementacion_SW/Pedal/Sources/HAL/DACDriver.h

/*
 * DACDriver.h
 *
 *  Created on: Jan 24, 2017
 *      Author: EdgarArmando
 */

#ifndef DACDRIVER_H_
#define DACDRIVER_H_

#define DAC_MODE			0

void DAC_vfnInit (void);
void DAC_vfnDisplay (unsigned short wData);

#endif /* DACDRIVER_H_ */
