Davibeh/Switch_De_Distorcion_Ergonomico/03_Investigacion_y_Desarrollo/04_Implementacion_SW/SDDE/Application/Efectos_de_Sonido/Distorcion.c

/*
 * Distorcion.c
 *
 *  Created on: Mar 24, 2018
 *      Author: Edgar Padilla Chung
 *---------------------------------------------------------
 * Change History
 * --------------------------------------------------------
 * Name: David Roberto Bellomo Gomez
 * Date: 31/03/18
 * Description: Alfa variant integration to the Beta variant:
 * 				1- Remove the check for the PIT flag, now this task is executed at interrupt level.
 * 				2- New managed of the ADC conversion, now the conversion is triggered and a wait for complete retains the core
 * 				3- Cleaning the code
 */
#include "Distorcion.h"

static unsigned short wMaxParameter = 860;

static unsigned short wDataToDAC;

void vfnDistorcion (void)
{
    		app_ADC_Trigger(APP_ADC_CHANNEL); /*Trigger the ADC channel conversion*/
    		while(ADC_ConvertioCheck(ADC_CHANNEL) != TRUE); /*This might be very dangerous. Need to determine if we may need to implement a timeout strategy*/
			if (4096 - wMaxParameter <= ADC_wfnLecture())
			{
				wDataToDAC = 4096;
			}
			else
			{
				wDataToDAC = ADC_wfnLecture();
			}
			if (wMaxParameter >= ADC_wfnLecture())
			{
				wDataToDAC = 0;
			}
			else
			{
				wDataToDAC = ADC_wfnLecture();
			}
			DAC_vfnDisplay(wDataToDAC);
}
