Davibeh/Switch_De_Distorcion_Ergonomico/03_Investigacion_y_Desarrollo/04_Implementacion_SW/SDDE/Application/app_Init.h

/*
 * app_Init.h
 *
 *  Created on: 23/10/2017
 *      Author: uidj2522
 */

#ifndef APP_INIT_H_
#define APP_INIT_H_

/******************************************
 * Includes
 ******************************************/

/******************************************
 * Defines
 ******************************************/

/******************************************
 * Variables
 ******************************************/

/******************************************
 * Prototypes
 ******************************************/
extern void app_Init_BETA(void);
extern void app_Init_ALFA(void);
#endif /* APP_INIT_H_ */
