Davibeh/Switch_De_Distorcion_Ergonomico/03_Investigacion_y_Desarrollo/04_Implementacion_SW/SDDE/Application/Efectos_de_Sonido/Electromiografo.h

/*
 * Electromiografo.h
 *
 *  Created on: Mar 24, 2018
 *      Author: Edgar Padilla Chung
 */

#ifndef ELECTROMIOGRAFO_H_
#define ELECTROMIOGRAFO_H_

#include "ADC_Driver.h"
#include "DACDriver.h"
#include "PITDriver.h"
#include "GPIODriver.h"

unsigned char vfnElectromiografo (void);
#endif /* ELECTROMIOGRAFO_H_ */
