Davibeh/Switch_De_Distorcion_Ergonomico/03_Investigacion_y_Desarrollo/04_Implementacion_SW/SDDE/Application/Efectos_de_Sonido/Inicializacion.h

/*
 * Inicializacion.h
 *
 *  Created on: Mar 24, 2018
 *      Author: Edgar Padilla Chung
 */

#ifndef INICIALIZACION_H_
#define INICIALIZACION_H_


#include "ADC_Driver.h"
#include "DACDriver.h"
#include "PITDriver.h"
#include "GPIODriver.h"


void vfnEfectinit (void); 

#endif /* INICIALIZACION_H_ */
