Davibeh/Switch_De_Distorcion_Ergonomico/03_Investigacion_y_Desarrollo/04_Implementacion_SW/SDDE/Application/MiografoAudio/Audio_Effect_Sig_ct.h

/*
 * Audio_Effect_Sig_ct.h
 *
 *  Created on: 25 mar. 2018
 *      Author: Bello
 */

#ifndef MIOGRAFOAUDIO_AUDIO_EFFECT_SIG_CT_H_
#define MIOGRAFOAUDIO_AUDIO_EFFECT_SIG_CT_H_

#define OUTPUT_ON 0xA5u
#define OUTPUT_OFF 0x5A
#define DEFAULT_VALUE 496 /*TODO set the correct value*/
#define OUTPUT_SIGNAL_STEP 120u

#endif /* MIOGRAFOAUDIO_AUDIO_EFFECT_SIG_CT_H_ */
