Davibeh/Switch_De_Distorcion_Ergonomico/03_Investigacion_y_Desarrollo/04_Implementacion_SW/SDDE/Application/app_DAC.h

/*
 * app_DAC.h
 *
 *  Created on: 28/02/2018
 *      Author: uidj2522
 */

#ifndef APP_DAC_H_
#define APP_DAC_H_

 /******************************************
 * Public Macros
 ******************************************/
 
 /******************************************
 * Public Typedef
 ******************************************/
 
 /******************************************
 * Public Const
 ******************************************/
 
 /******************************************
 * Public Variables
 ******************************************/
 
 /******************************************
 * Public Prototypes
 ******************************************/
extern void app_DAC_Init(void);
extern void app_DAC_TaskMngr(void);

#endif /* APP_DAC_H_ */
