Davibeh/Switch_De_Distorcion_Ergonomico/03_Investigacion_y_Desarrollo/04_Implementacion_SW/SDDE/Application/app_PIT.h

/*
 * app_PIT.h
 *
 *  Created on: 23/10/2017
 *      Author: uidj2522
 */

#ifndef APP_PIT_H_
#define APP_PIT_H_

/******************************************
 * Includes
 ******************************************/
#include "stdtypedef.h"

/******************************************
 * Defines
 ******************************************/

/******************************************
 * Variables
 ******************************************/
extern T_UBYTE rub_PITAlarm;

/******************************************
 * Prototypes
 ******************************************/
extern void app_PIT_Init(void);

#endif /* APP_PIT_H_ */
