Davibeh/Switch_De_Distorcion_Ergonomico/03_Investigacion_y_Desarrollo/04_Implementacion_SW/SDDE/source/stdtypedef.h

/*
 * stdtypedef.h
 *
 *  Created on: 14/10/2017
 *      Author: uidj2522
 */

#ifndef STDTYPEDEF_H_
#define STDTYPEDEF_H_

#define KINETIS_KL25Z

typedef void( *FCT_POINTER )(void);

typedef unsigned char 	T_UBYTE;
typedef unsigned short 	T_UWORD;

#define TRUE		((T_UBYTE)(1U))
#define FALSE		((T_UBYTE)(0U))

#define NULL ((void *)0)

#endif /* STDTYPEDEF_H_ */
