Davibeh/Switch_De_Distorcion_Ergonomico/(commit log)

2018-03-30 Primera configuración
    Primera configuración del proyecto:
    1- Se agregaron los folder y un archivo que describe el contenido de los mismos
    2- Se agregaron los archios de finanzas, los planes de proyecto, la architectura de HW y SW.
    3- Se agregón un documento manual para abir la arquitectura de SW y HW-
    4- Se creo un proyecto en MCU xpresso
    [BOM para Proyecto.xlsx, Req_Switch_Ergonomico.xls, Requerimientos_Propuesto_Gerardo.xls, Requerimientos_v01_David.xls, board.brd, board.sch, electromiografo.brd, electromiografo.sch]
2018-03-31 First integration of Alfa and Beta Software
    Consiste en la inclusion de las funcionalidades de efectos de sonido en la conifiguracíon de sistema provista por MCU expresso
2018-04-01 Segund Integración del SW alfa
    Se integráron las funciones de efecto de sonido Vibrato y Distorción.
    Al parecer vibrato no funciona se levantó el issue #9
    [Requerimientos_Propuesto_Gerardo.xls, Requerimientos_Propuesto_Gerardo.xlsx]
2018-04-01 Third Integraton of Alpah Beta variants
    This is the first full integration of the alfpha beta variants.
    The Scheduler is not working properly, the loop never reaches the task execution, the workaround is to use the 1ms PIT IRQ and execute the 1ms taks there.
    Need to analyze if the problem can be solved an use the correct Scheduler.
    The movement is dected but with the Computer the voltage suplly makes the EMG to vary to much in a way that is not detectable by the SW. the normal averge voltage is 1300 counts that corresponds to 1v and it doe snto vary to much.
    This issue is known and it needs the board disconnected form the computer, unfurtunatelly is not possible right now there is and iss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
    [EMG_Control.c, EMG_Control.h, Efectos_De_Sonido.c, Efectos_De_Sonido.h, app_ADC.h, app_PIT.c, main.c]
2018-04-01 Cambios de configuración proyecto MCUxpresso y WBS
    Se agregó el WBS de Chung.
    Se cambió la configuración en mcuxpresso de manaera que ahora es factible el utulizar la configuración "release" y "debug".
2018-04-12 Add files via upload
    se agregaron puntos visto en clase
    Nota. versiones anteriores de ambos documentos se encuentran los comentarios de los respectivos issues
2018-04-12 cambio en fases
    se agrego la fase de planeacion en project charter y en la presentación
2018-04-12 Formato proyect charter
    Cambio en el formato el proyect charter
2018-04-24 Commit de Entrega
    Subir todos los archivos y cambios relizados ene l proyecto.
    [Fechas_del_Proyecto.xlsx, RACI_Switch_de_distorción_ergonónico.xlsx, Req_Switch_Ergonomico.xls, Requerimientos_Propuesto_Gerardo.xlsx, Requerimientos_v01_David.xls]
